jettronics/Homesystem/README.md

# Homesystem

## Introduction
The Homesystem project has been created to provide web radio stream for different rooms. Which can be controlled by Alexa, by Smart Phone and by a Remote controller centrally.
Further more the Homesystem acts as an Alarm center to monitor different sensors like water sensor to protect for water damage. In case of an Alarm the Homesystem can send Push Messages to a Smart Phone.

## Overview
The Homesystem centeral unit is realized by a Raspberry PI 3B+ controller module. 

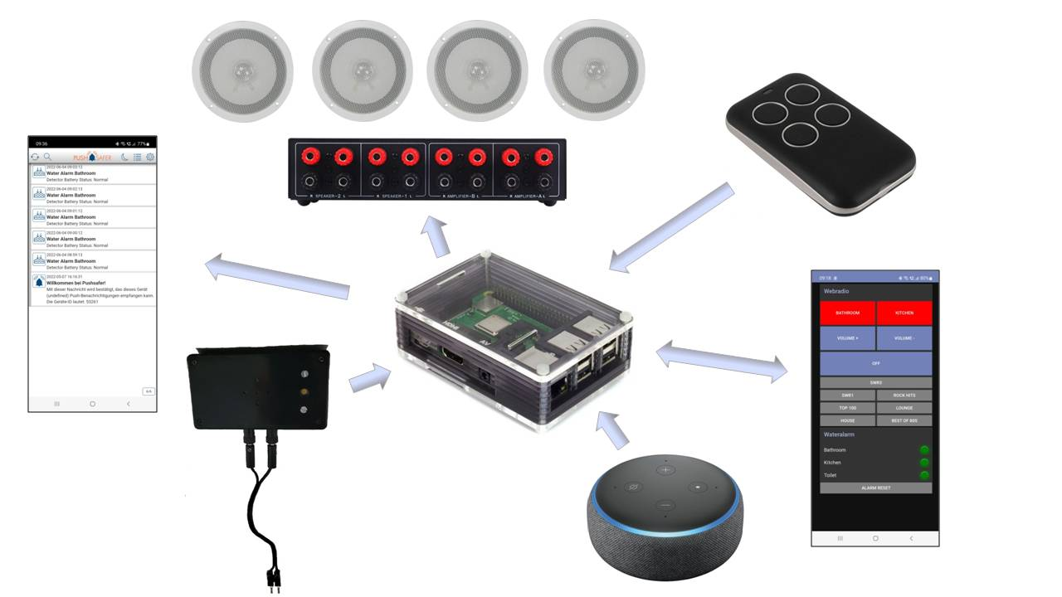
[picture p1: Images/Overview.jpg]
Overview
  

Radio can be played by Loudspeakers installed in different rooms of the appartment. Controlling the radio streams can be happened by different ways
* Alexa - The speech command for radio streaming is routed over Alexa to the Central unit. 
* Smart Phone - A browser interface is provided by NodeRED
* Remote Controller - A FM based controller to control the radio player on Central unit.

With the MPD (Music Player Daemon) player running on Central unit a list of radio streaming provides can be selected.  
Sensors detect water flowing accidentally on floor. Sensor Alarm messages are routed by a FM (433MHz) link between Sensor and Central unit.
In case of water detection push messages will be sent which can be received and read on Smartphone.
For further technical details see Wiki page.
## Operation
The User can interact with the Homesystem over Alexa Speech Commands, Smart Phone Interface and Remote Controller.
### Alexa Speech Commands
Node RED uses amazon-echo-device-nodes to receive speech commands from Alexa. For Alexa those nodes are visible as a Light Bulb and can be speech controlled accordingly.
Following Speech Commands are available:
* Radio Küche
* Radio Bad
* Lieblingssender
* Was anderes
* Radio lauter
* Radio leiser

To activate webradio in kitchen say e.g. "Alexa, schalte Radio Küche ein!"
### Smart Phone Interface
There are two tabs as Interface to Homesystem.  
The first one is to control Webradio with different stations.  
  
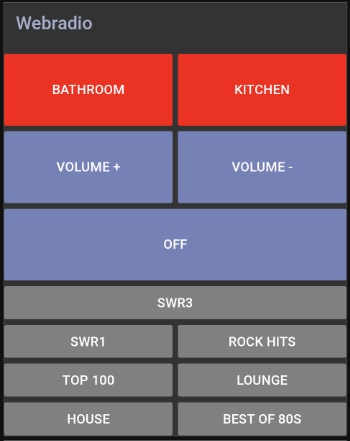
[picture p2: Images/WebradioScreenShot.png]
Webradio
  
  
The next tab shows the status of the different Watersensors.  
  
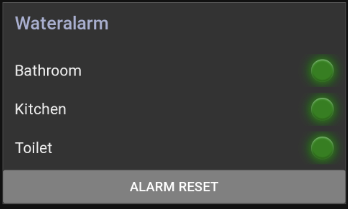
[picture p3: Images/WateralarmScreenShot.png]
Wateralarm
  
  
Green LED means no water detected. Red LED means water detected. In case of Water detection a Push message will be sent to Smart Phone.
### Remote Controller
The Remote Controller is a small device to control Webradio by 4 buttons.
* On/Off Webradio
* Next Webradio station
* Volume up
* Volume down
  
### Water Detection
This sensor device detects water and sends an appropiate signal to Homesystem centrals unit. 
The Homesystem acts as a gateway and sends push messages on registered Smart phones in case of water detected. 
The sensor draws very less standby current so that the battery can be used a very long time.

## Improvements
- [x] HF Transmission for Remote Controller just Parity Bit checked. For more robust transmission a CRC check or similiar check can be used.
- [x] Loud speaker announcement for the Webradio channel when changing the Webradio channel over e.g. Speech commands.
