jettronics/Homesystem/DetectorHardware/Readme.txt

RATS in board command line to fill polygon
