jettronics/Homesystem/Images/SupplyVoltage.pptx

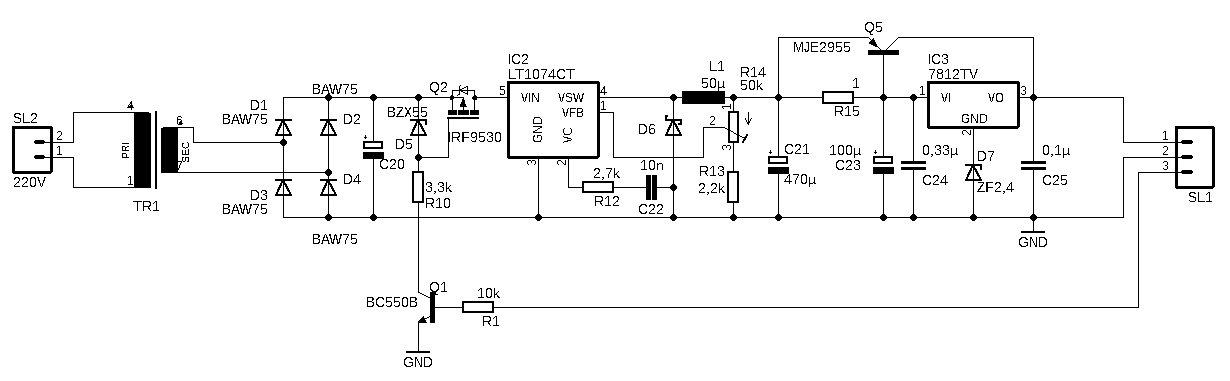
[picture p4: figure]

Rectification

On/Off Control

Buck Converter

Stabilization

Transformer

## Slide 2

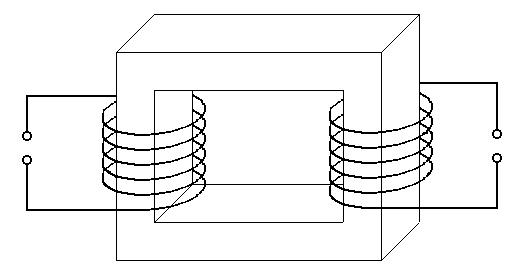
[picture p5: figure]

i2

i1

u1

N1

(dφ)/(dt)

N2

u2

## Slide 3

u2

u1

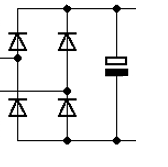
[picture p6: figure]
