jettronics/Homesystem/Notes/links.txt

Text to speech:
https://ttsmp3.com/
Online audio converter:
https://online-audio-converter.com/de/
