jettronics/Homesystem/Images/AmplifierHardwareSchematic.jpg

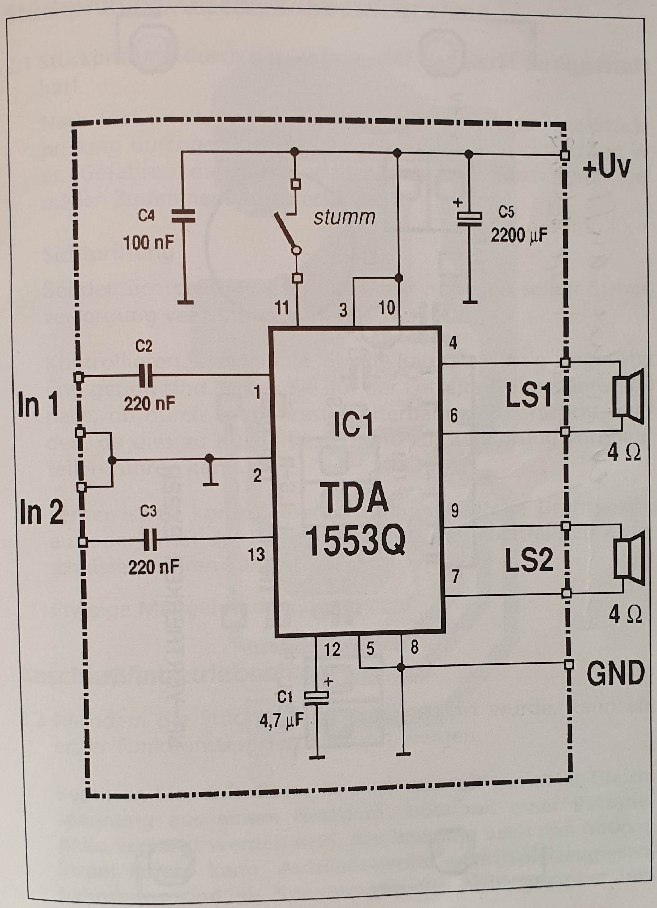
Images/AmplifierHardwareSchematic.jpg
