jettronics/Homesystem/Images/AmplifierHardwareSupplySchematic.png

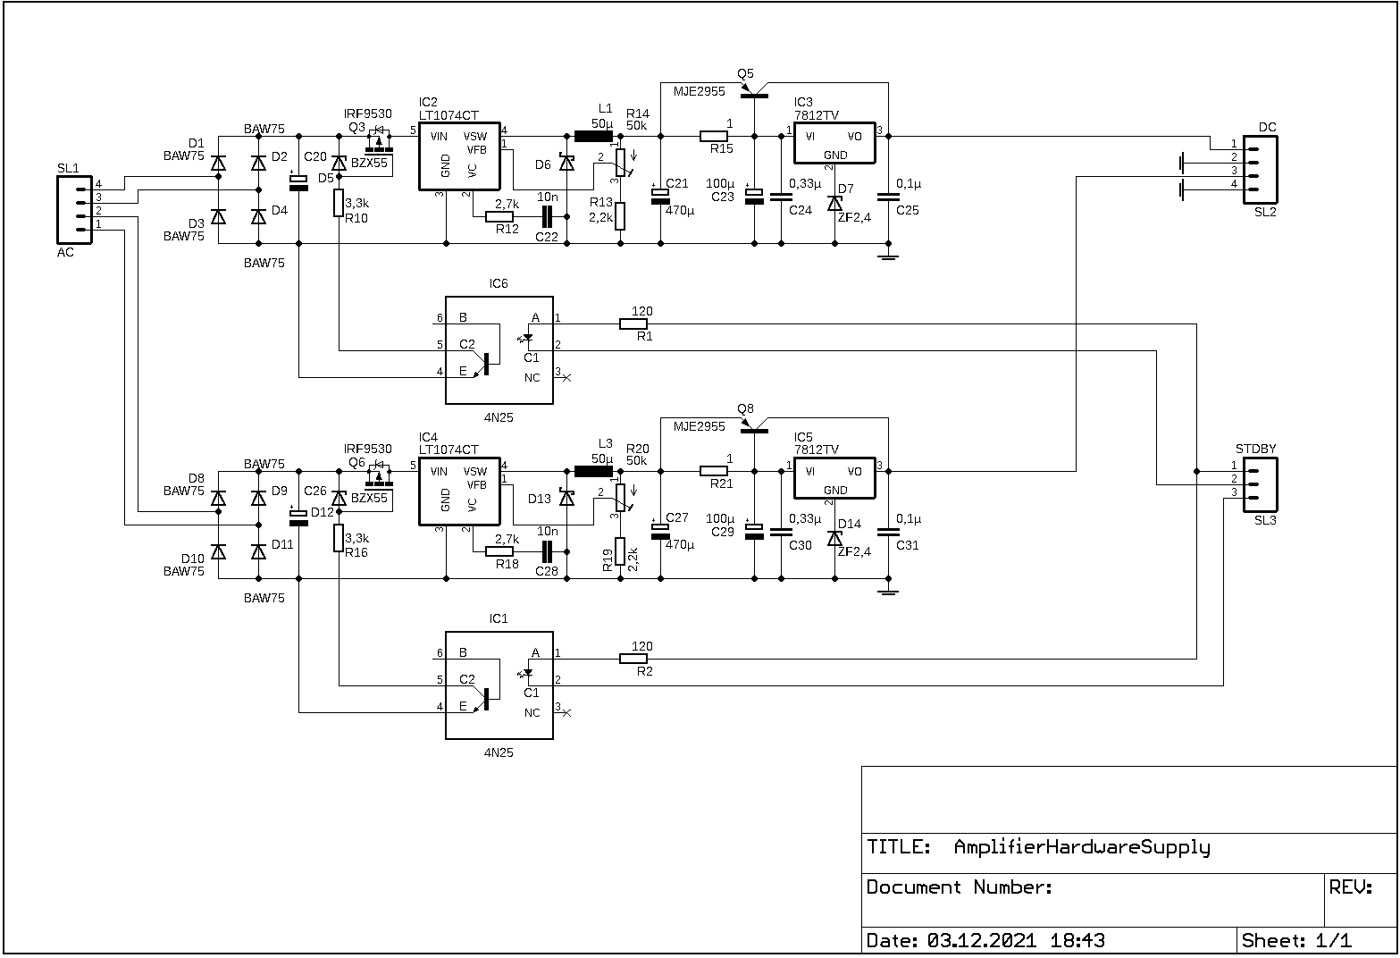
Images/AmplifierHardwareSupplySchematic.png
