jettronics/Homesystem/Images/AmplifierHardwareSupplySchematic_Split.png

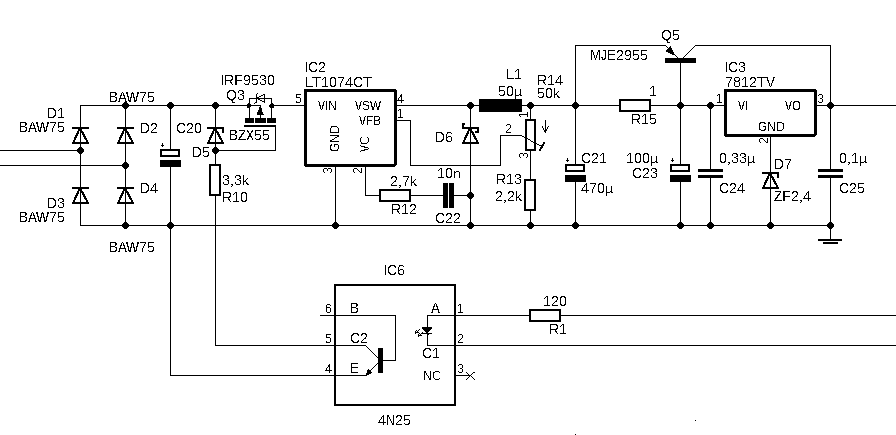
Images/AmplifierHardwareSupplySchematic_Split.png
