jettronics/Homesystem/Images/BiPhasMarkCode.png

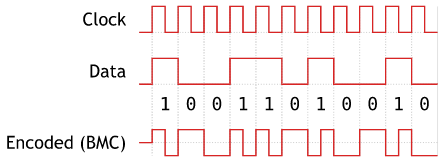
Images/BiPhasMarkCode.png
