jettronics/Homesystem/Images/DetectorFirmwareStateMachine.png

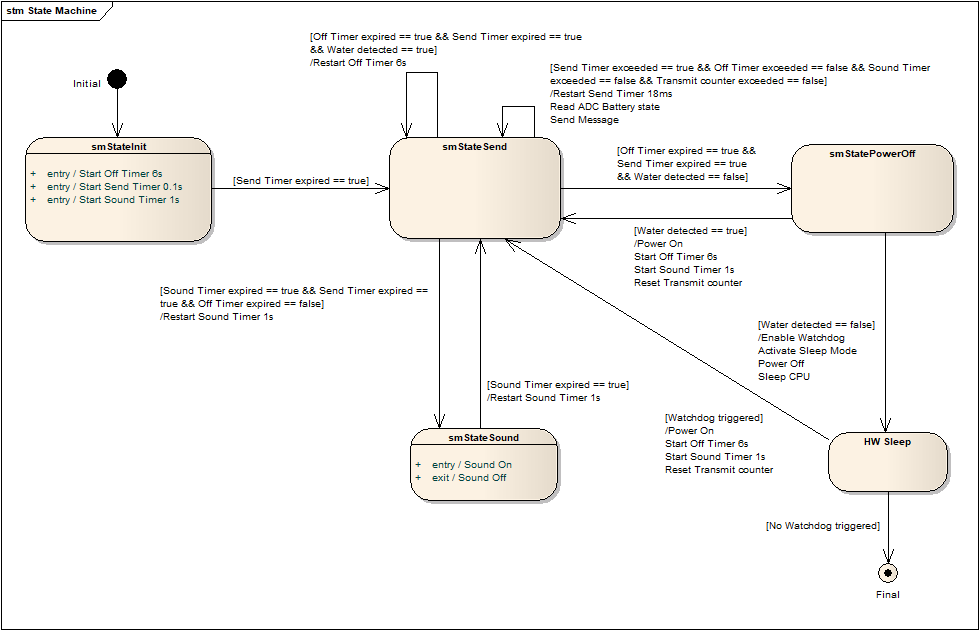
Images/DetectorFirmwareStateMachine.png
