jettronics/Homesystem/Images/DetectorHardwareSchematic.png

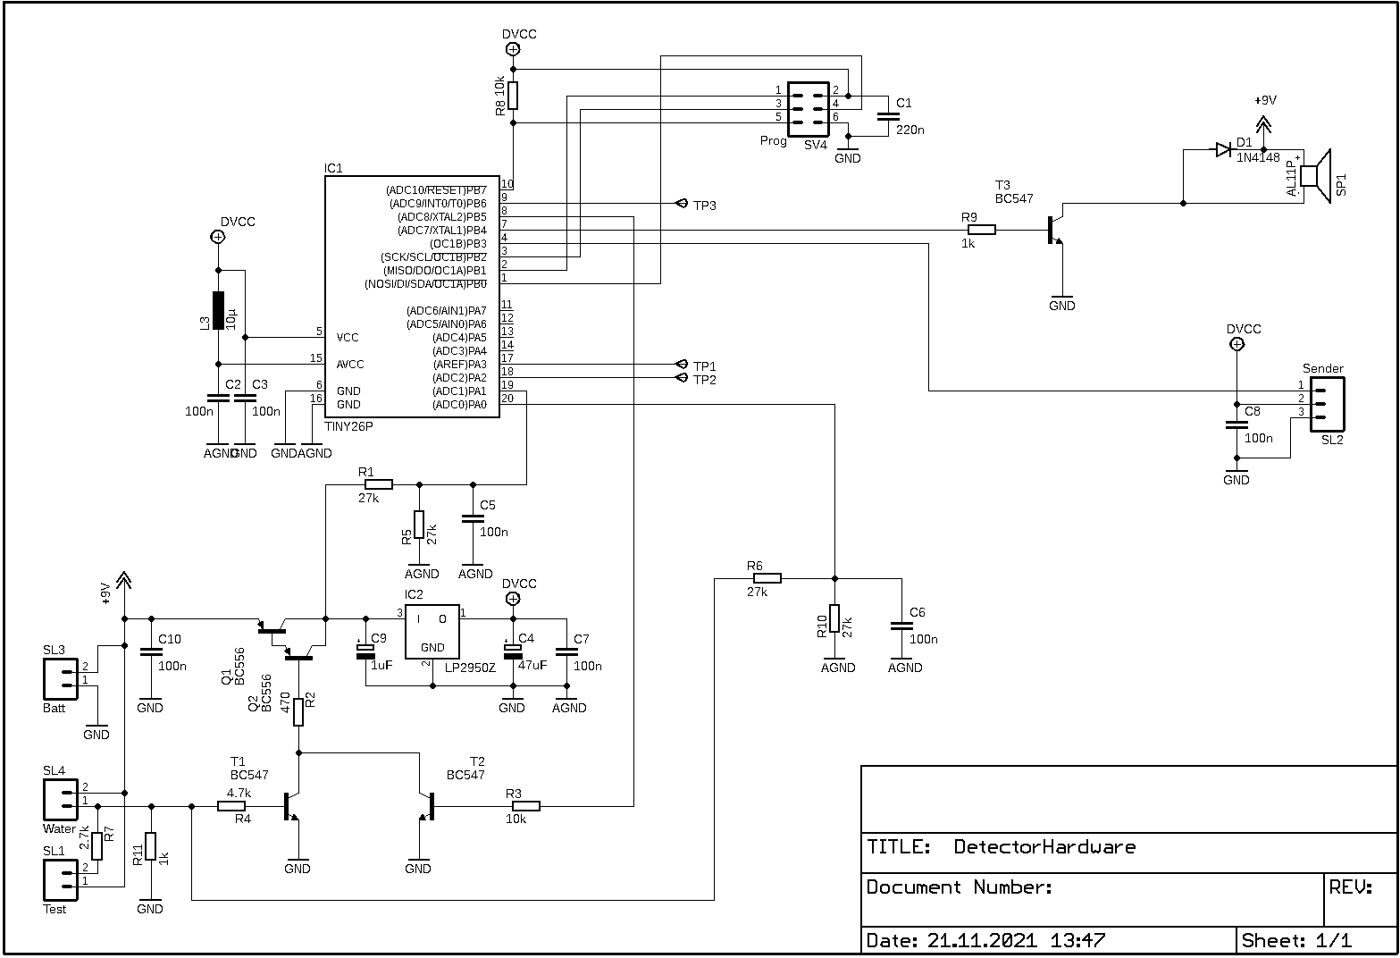
Images/DetectorHardwareSchematic.png
