jettronics/Homesystem/Images/DetectorHardwareSchematic_Split.png

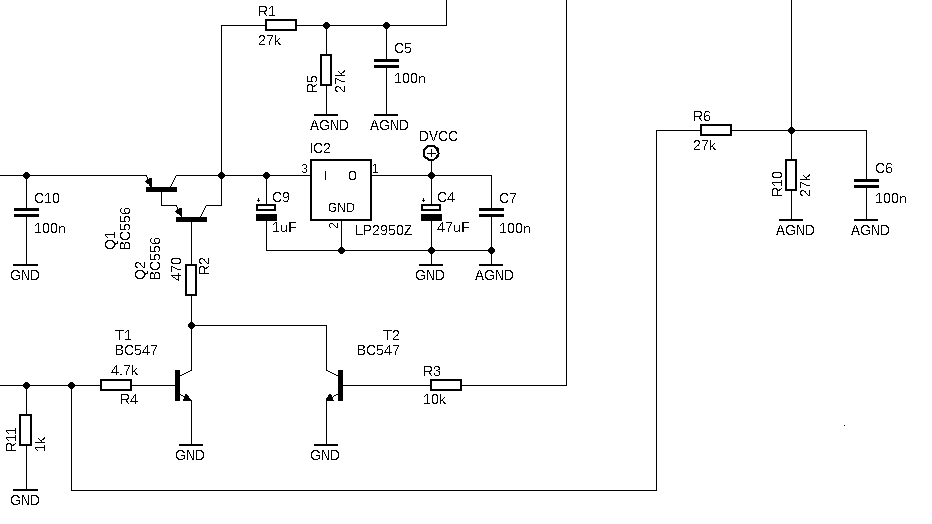
Images/DetectorHardwareSchematic_Split.png
