jettronics/Homesystem/Images/FS1000ATransmitter433MHz.png

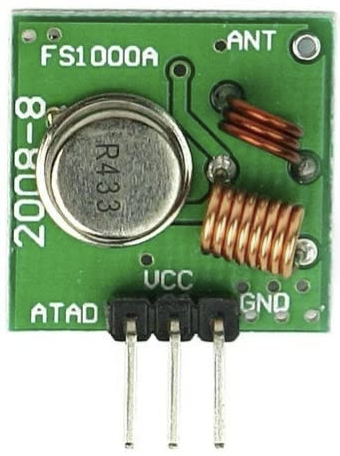
Images/FS1000ATransmitter433MHz.png
