jettronics/Homesystem/Images/IRF9530_VGS_ID.jpg

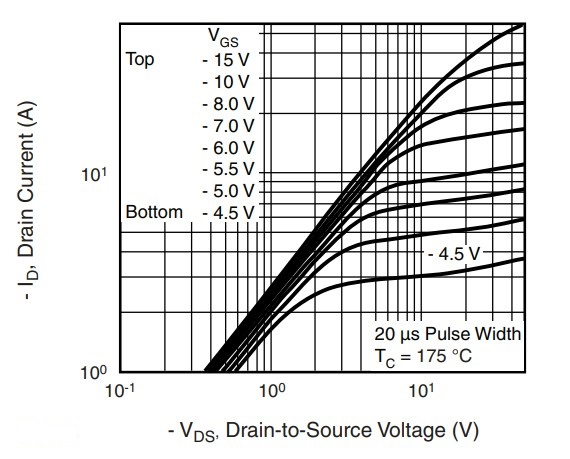
Images/IRF9530_VGS_ID.jpg
