jettronics/Homesystem/Images/NodeREDAmazonEchoNodes.png

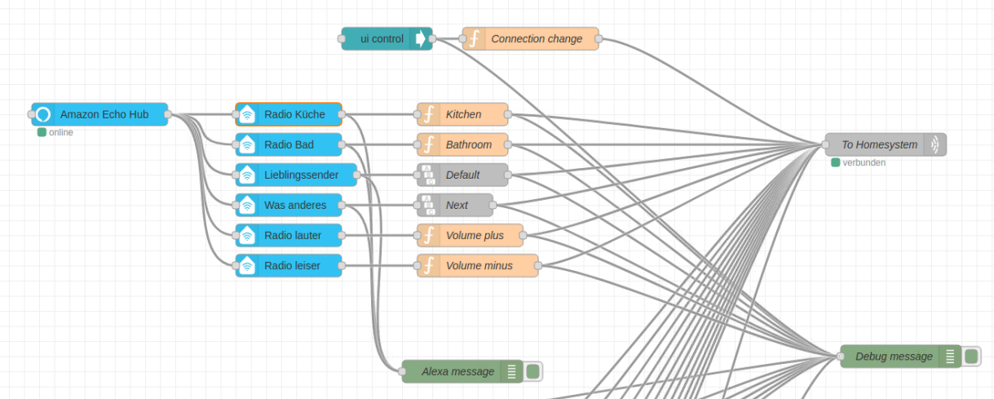
Images/NodeREDAmazonEchoNodes.png
