jettronics/Homesystem/Images/NodeREDSmartPhoneNodes.png

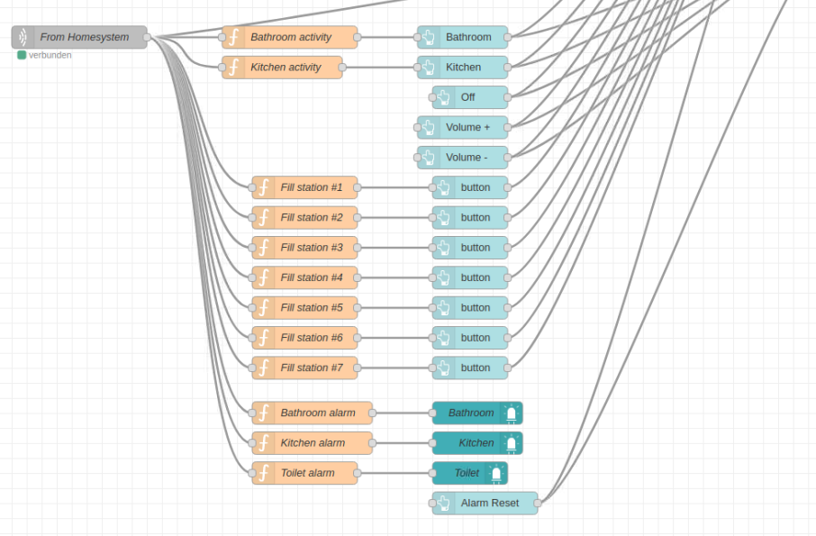
Images/NodeREDSmartPhoneNodes.png
