jettronics/Homesystem/Images/RemoteHardwareSchematic.png

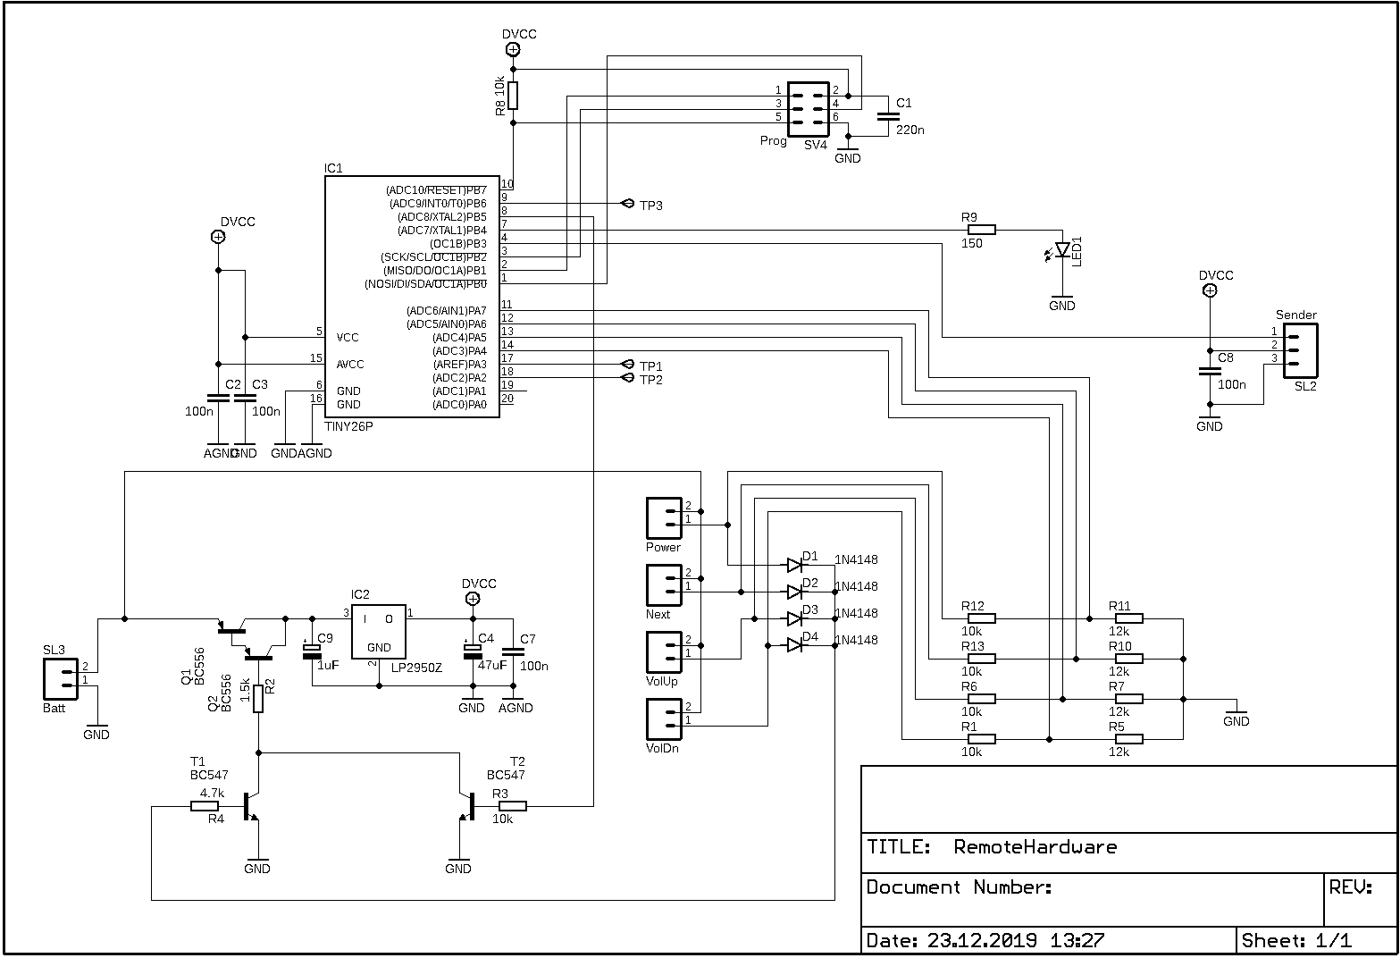
Images/RemoteHardwareSchematic.png
