jettronics/Homesystem/Images/retification.jpg

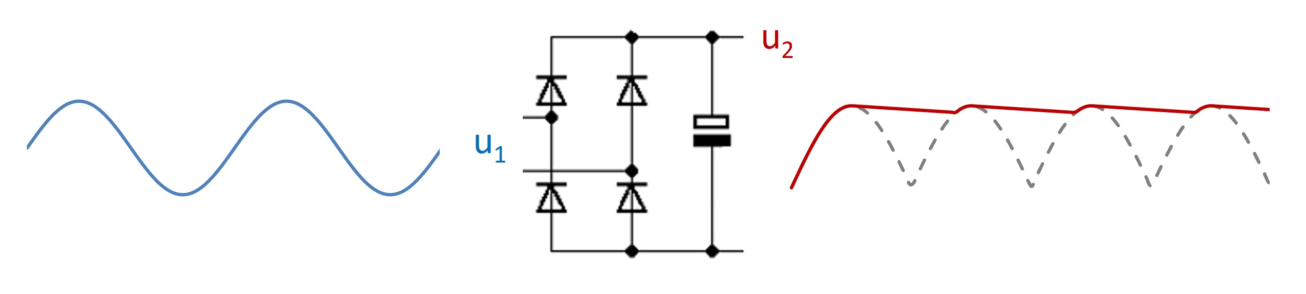
Images/retification.jpg
