jettronics/Homesystem/Images/RXB6SuperheterodyneReceiver433MHz.png

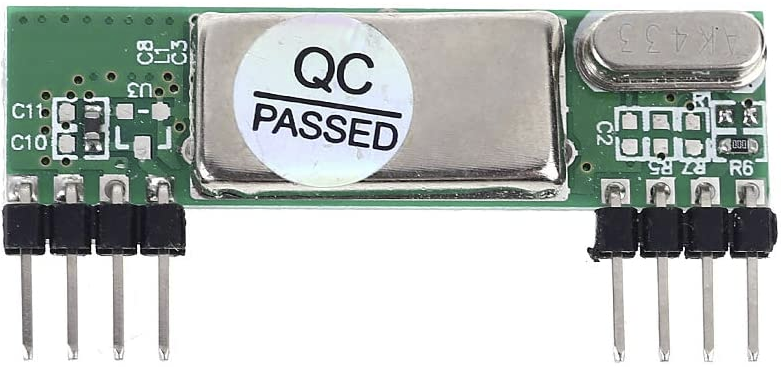
Images/RXB6SuperheterodyneReceiver433MHz.png
