jettronics/Homesystem/Images/ServerFirmwareStateMachine.png

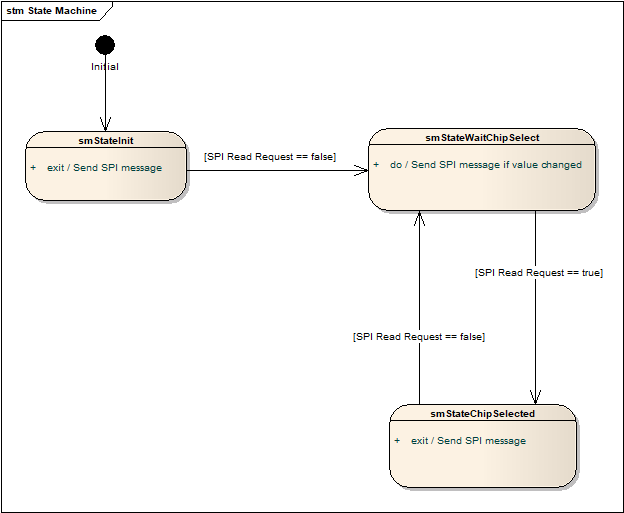
Images/ServerFirmwareStateMachine.png
