jettronics/Homesystem/Images/ServerHardwareSchematic.png

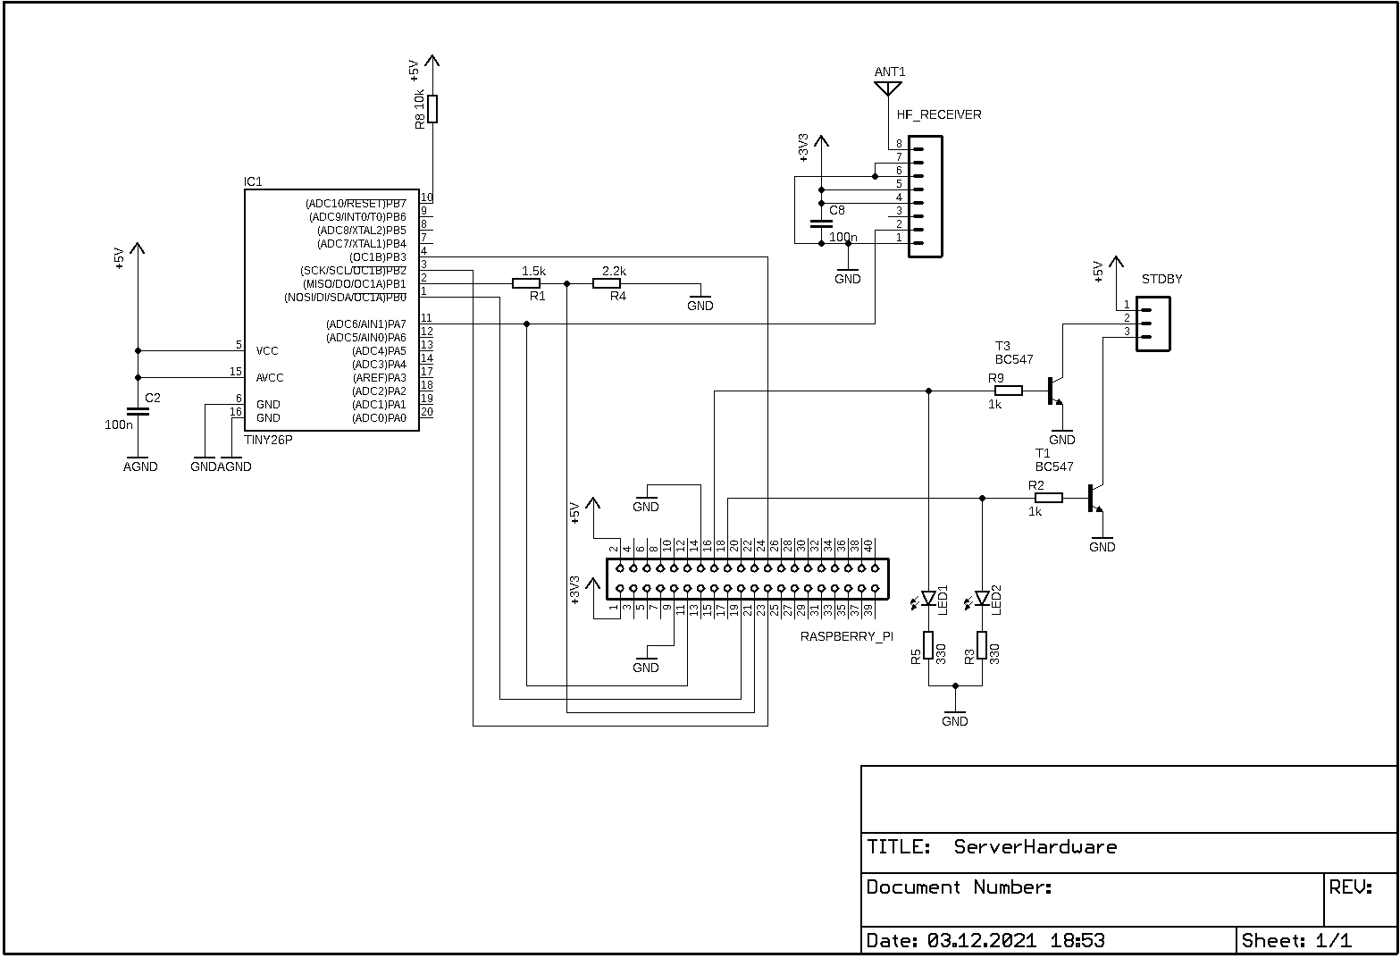
Images/ServerHardwareSchematic.png
