jettronics/Homesystem/Images/ServerSoftware.png

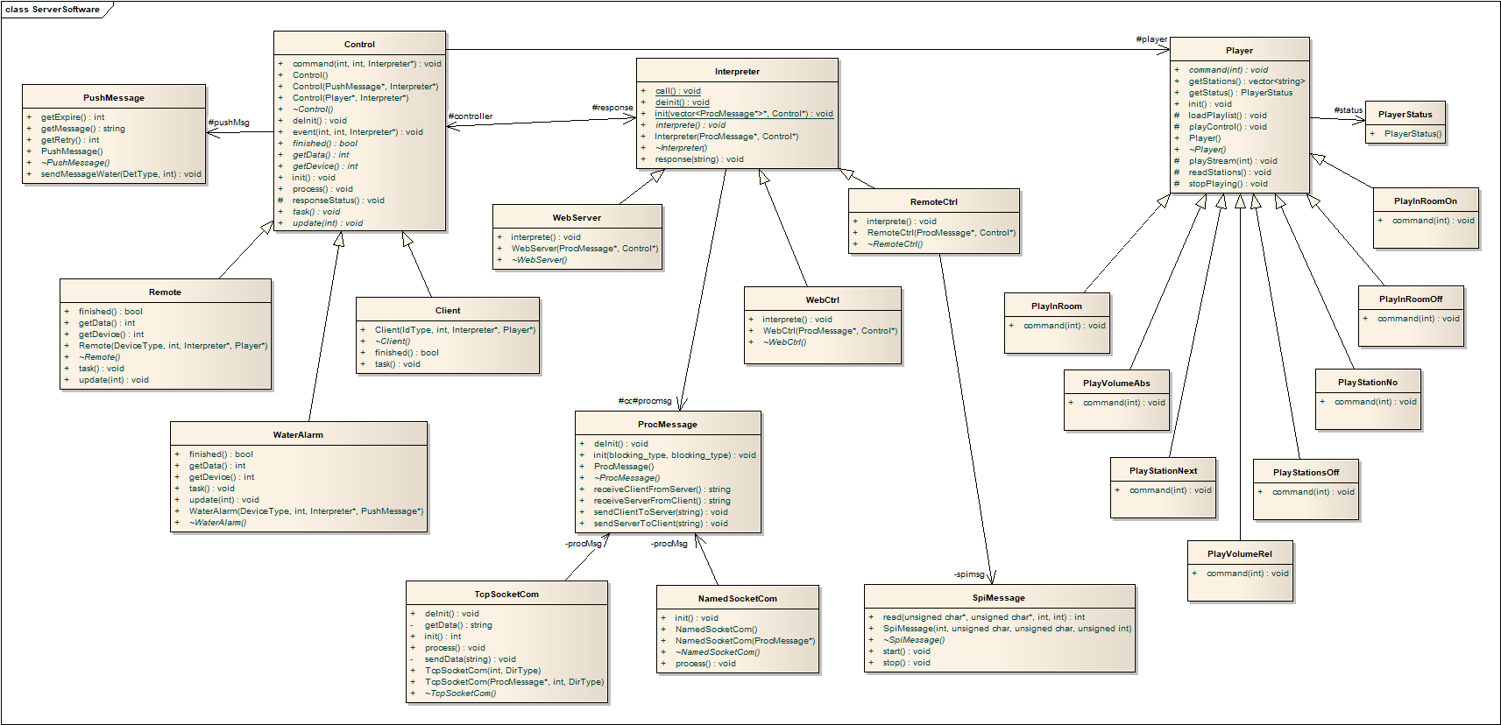
Images/ServerSoftware.png
