jettronics/Homesystem/Images/SupplyVoltage.jpg

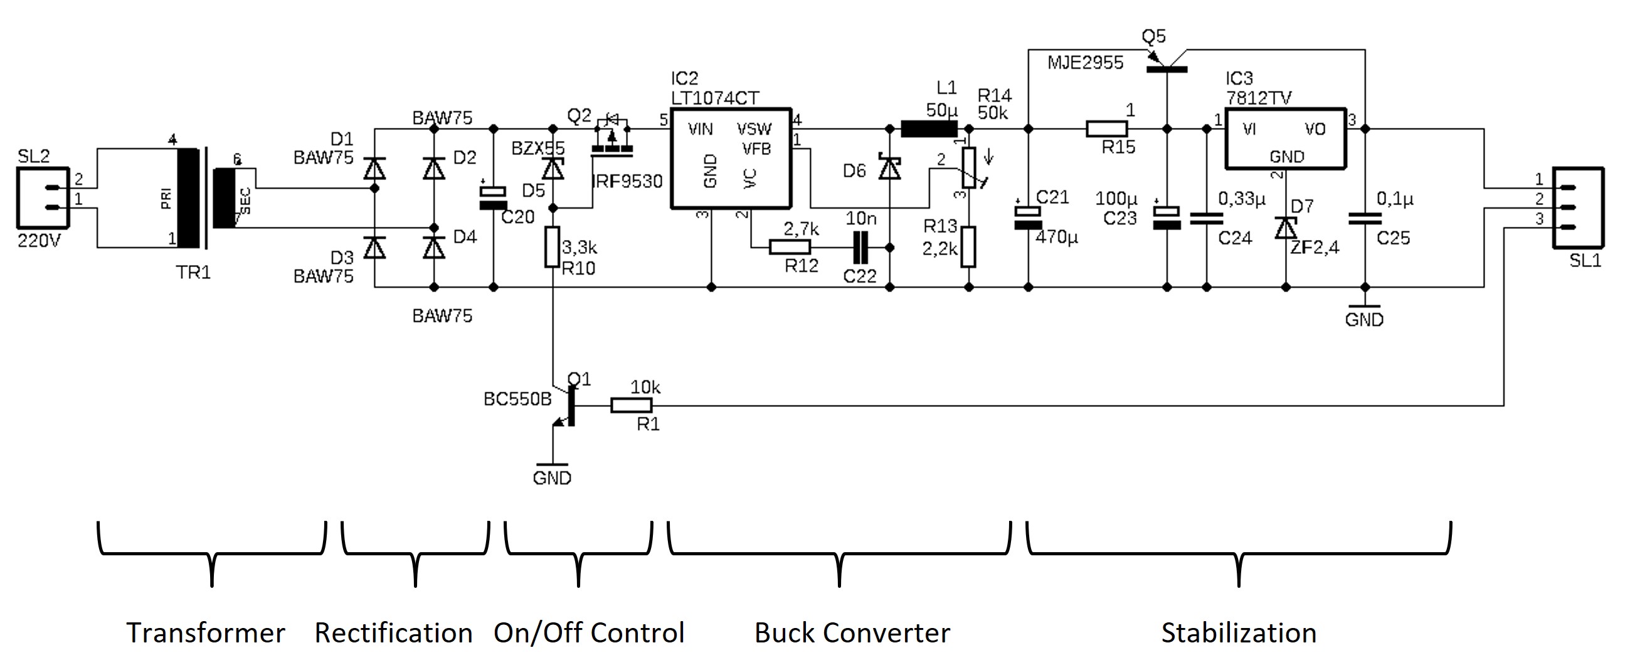
Images/SupplyVoltage.jpg
