jettronics/Homesystem/Images/transformer.jpg

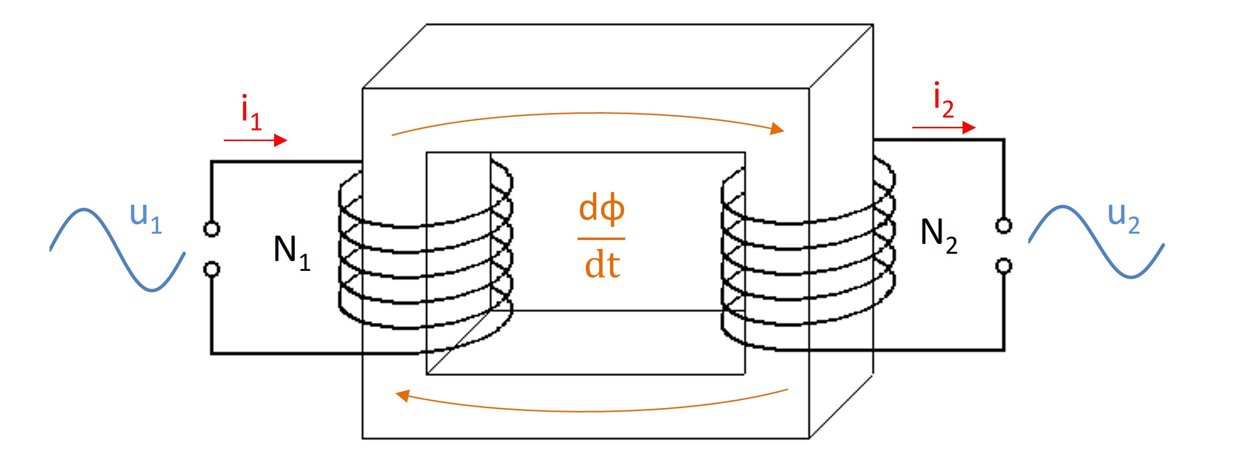
Images/transformer.jpg
