jettronics/Homesystem/Images/VoltageSupply.png

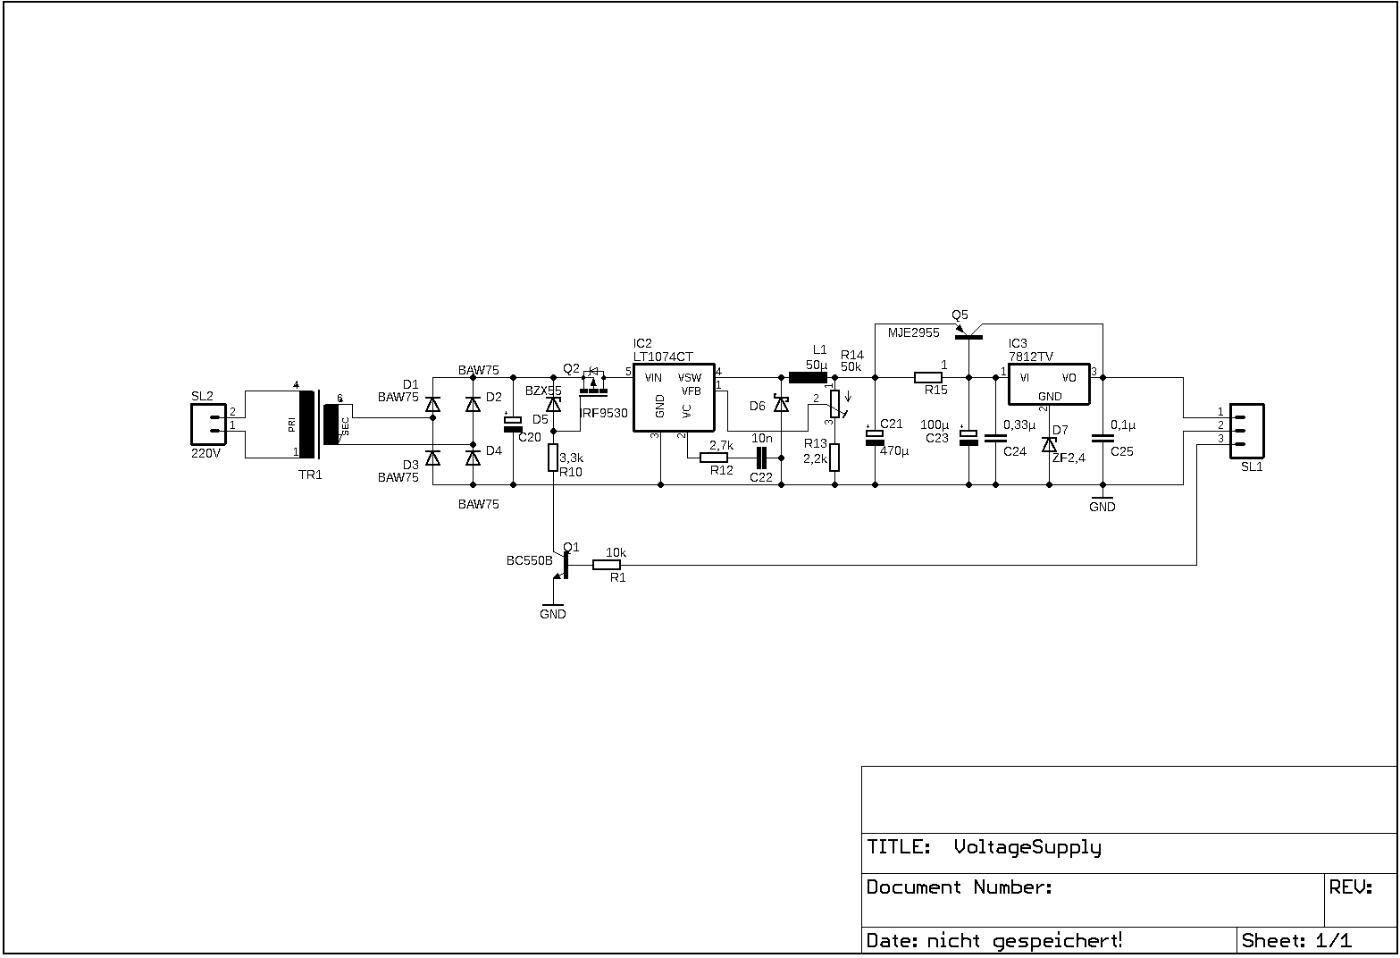
Images/VoltageSupply.png
