jettronics/Homesystem/AmplifierHardware/AmplifierHardwareSupply.brd

## EAGLE design AmplifierHardware/AmplifierHardwareSupply.brd (2021-12-03)

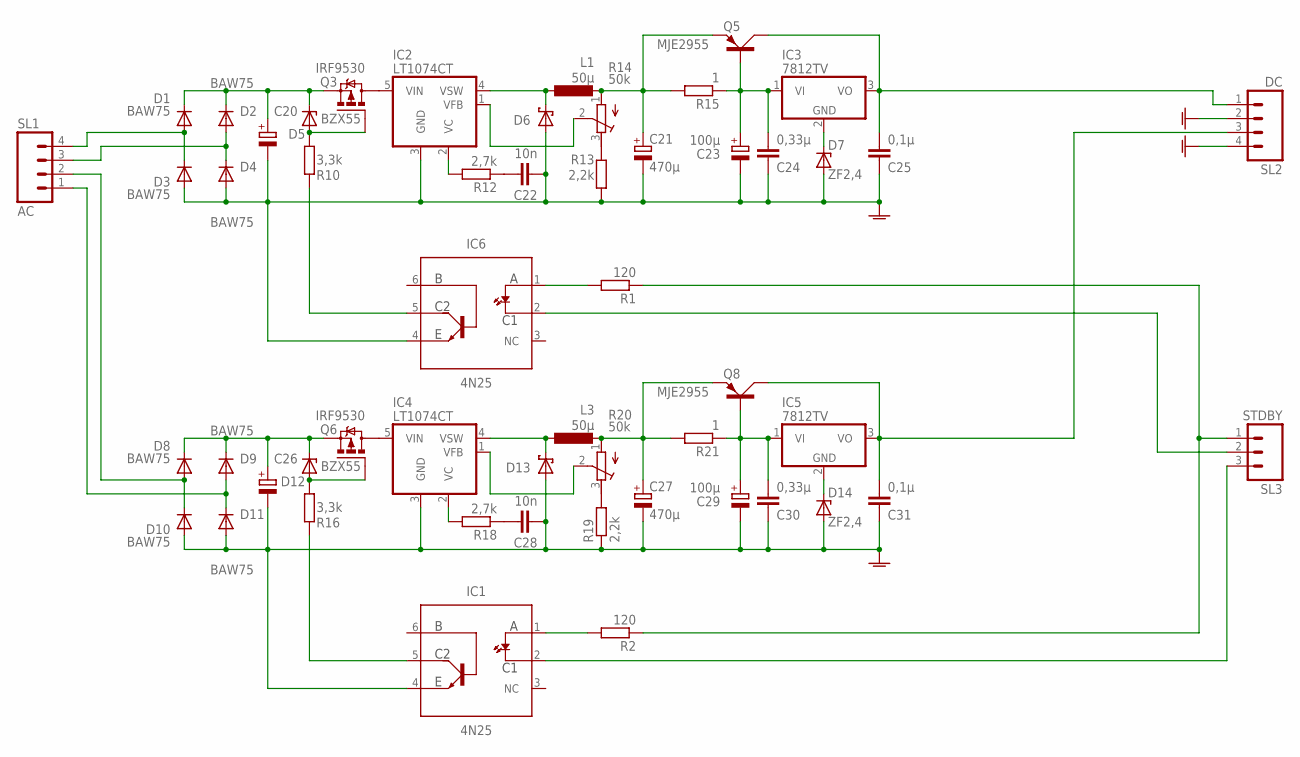
[picture p27: schematic AmplifierHardwareSupply.sch]

Parts:
C20, C26: CPOL-EUE5-10.5; E5-10,5
C21, C27: 470µ; E5-10,5
C22, C28: 10n; C025-024X044
C23, C29: 100µ; E5-10,5
C24, C30: 0,33µ; C025-024X044
C25, C31: 0,1µ; C025-024X044
D1, D2, D3, D4, D8, D9, D10, D11: BAW75; DO35-10
D5, D12: BZX55; DO35Z10
D6, D13: SCHOTTKY-DIODEDO35-7; DO35-7
D7, D14: ZF2,4; DO34Z7
IC1, IC6: 4N25; DIP762W60P254L712H480Q6B
IC2, IC4: LT1074CT; TO220-5
IC3, IC5: 7812TV; TO220V
L1, L3: 50µ; TJ3-U1
Q3, Q6: IRF9530; TO220BV
Q5, Q8: MJE2955; TO220AV
R1, R2: 120; 0207/2V
R10, R16: 3,3k; 0207/2V
R12, R18: 2,7k; 0207/2V
R13, R19: 2,2k; 0207/2V
R14, R20: 50k; RTRIM64W
R15, R21: 1; 0207/2V
SL1: AC; 04P
SL2: DC; 04P
SL3: STDBY; 03P

Connections:
+UB2: C31.2, IC5.3 (VO), Q8.C, SL2.3
AGND: C20.-, C21.-, C22.2, C23.-, C24.1, C25.1, C26.-, C27.-, C28.2, C29.-, C30.1, C31.1, D3.A, D4.A, D6.A, D7.A, D10.A, D11.A, D13.A, D14.A, IC1.4 (E), IC2.3 (GND), IC4.3 (GND), IC6.4 (E), R13.1, R19.1, SL2.2, SL2.4
unnamed: C25.2, IC3.3 (VO), Q5.C, SL2.1
unnamed: R1.1, R2.1, SL3.1
unnamed: IC6.1 (A), R1.2
unnamed: IC1.1 (A), R2.2
unnamed: IC6.2 (C1), SL3.2
unnamed: IC1.2 (C1), SL3.3
unnamed: IC2.2 (VC), R12.2
unnamed: R13.2, R14.3 (A)
unnamed: D1.A, D3.C, SL1.4
unnamed: IC4.2 (VC), R18.2
unnamed: IC2.5 (VIN), Q3.D
unnamed: D5.A, Q3.G, R10.2
unnamed: IC6.5 (C2), R10.1
unnamed: C21.+, L1.2, Q5.E, R14.1 (E), R15.2
unnamed: C22.1, R12.1
unnamed: D6.C, IC2.4 (VSW), L1.1
unnamed: IC2.1 (VFB), R14.2 (S)
unnamed: D7.C, IC3.2 (GND)
unnamed: R19.2, R20.3 (A)
unnamed: C23.+, C24.2, IC3.1 (VI), Q5.B, R15.1
unnamed: D8.A, D10.C, SL1.2
unnamed: D9.A, D11.C, SL1.1
unnamed: C26.+, D8.C, D9.C, D12.C, Q6.S
unnamed: D12.A, Q6.G, R16.2
unnamed: IC1.5 (C2), R16.1
unnamed: C28.1, R18.1
unnamed: D13.C, IC4.4 (VSW), L3.1
unnamed: IC4.5 (VIN), Q6.D
unnamed: C27.+, L3.2, Q8.E, R20.1 (E), R21.2
unnamed: IC4.1 (VFB), R20.2 (S)
unnamed: C29.+, C30.2, IC5.1 (VI), Q8.B, R21.1
unnamed: D14.C, IC5.2 (GND)
unnamed: C20.+, D1.C, D2.C, D5.C, Q3.S
unnamed: D2.A, D4.C, SL1.3

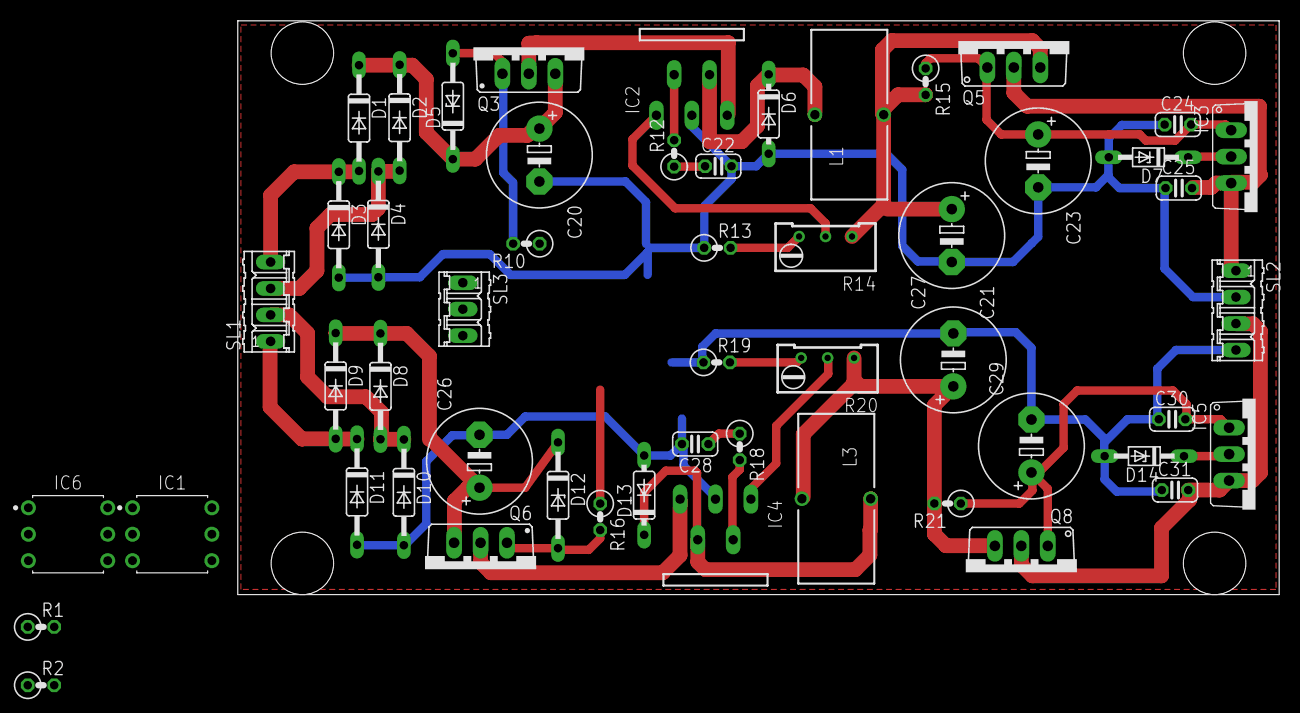
[picture p28: board AmplifierHardwareSupply.brd from above]

Board: 2 copper layers, 100.0 x 55.1 mm, 53 parts (0 on the bottom side), 36 nets.
