jettronics/Homesystem/(commit log)

2021-11-01 All missing Firmware, Hardware folders added
    [DetectorHardware.brd, DetectorHardware.sch, RemoteHardware.sch]
2021-11-21 Server Software and Server Hardware documentation
    [ServerHardware.sch]
2021-12-03 Amplifier Hardware Schematic
    [AmplifierHardwareSupply.brd, AmplifierHardwareSupply.sch]
2021-12-03 Server Hardware Schematic renamed
    [ServerHardware.sch]
2022-07-24 Overview image and powerpoint
2023-07-06 Parity replaced by CRC code
    [Transmit_crc.c, Types.h]
2023-07-07 Compare check removed, Parity check by Syndrom decoding replaced
    [Receive.c]
2026-02-19 Voltage Supply
    [VoltageSupply.sch]
2026-02-24 Supply Voltage schematic adapted
    [VoltageSupply.sch]
2026-02-24 Supply Voltage image adapted
